Envyles/OpenAnalogToRS485/README.md

# OpenAnalogToRS485
A open analog to RS485 converter board based on the STM32 and ADC 1115.

I will write a Manual if i have some time in the next Days.

This STM32 based board is made for the purpose to read analog Data from enviromental sensors and provide it in a ascii style formated Output.

Its released under the Creative Commons CC BY-SA license. 

EN: https://creativecommons.org/licenses/by-sa/3.0/
DE: https://creativecommons.org/licenses/by-sa/3.0/de/

It is provided AS-IS, with no further Warranty.
