Envyles/OpenAnalogToRS485/BOM_Open-Analog-To-RS485_2021-02-01.csv

ID | Name | Designator | Footprint | Quantity | Manufacturer Part | Manufacturer | Supplier | Supplier Part | JLCPCB SMD | LCSC Assembly
1 | Header | RS485PIN | HDR-2X1/2.54 | 1 | Header-Male-2.54_1x2 | EasyEDA | EasyEDA | E36717
2 | Canbus 120 ohm terminator jumper | TERMINATORJUMPER_RS485 | HDR-2X1/2.54 | 1 | Header-Male-2.54_1x2 | EasyEDA | EasyEDA | E36717
3 | Power | POWER_CONECTOR,LED_CON | HDR-2X1/2.54 | 2 | Header-Male-2.54_1x2 | EasyEDA | EasyEDA | E36717
4 | ProgramHeader | PROGRAMMING | HDR-4X1/2.54 | 1 | Header-Male-2.54_1x4 | EasyEDA | EasyEDA | E59481
5 | BAV199 | D1,D2,D3,D4 | SOT-23-3_L3.0-W1.7-P0.95-LS2.9-BR | 4 | BAV199 | CJ | LCSC | C68971 | Yes
6 | 8MHz | X1 | OSC-SMD_L5.0-W3.2 | 1 | X50328MSB2GI | YXC | LCSC | C115962 | Yes
7 | 32.768KHz | X3 | SMD-2012_2P | 1 | DST210AC 32.768KHz | KDS | LCSC | C93231 | Yes
8 | 680uF | C14 | CAP-SMD_BD10.0-L10.3-W10.3-RD | 1 | VZH681M1CTR-1010 | LELON | LCSC | C164080 | Yes
9 | LM2596SX-5.0/NOPB | U9 | TO-263-5_L10.2-W9.9-P1.70-LS14.4-TL | 1 | LM2596SX-5.0/NOPB | TI | LCSC | C10002 | Yes
10 | 22uH | L3,L4,L5 | L0805 | 3 | SDFL2012T220KTF | Sunlord | LCSC | C32375 | Yes
11 | 1.5K | R15,R20,R22,R23,R24 | R0603 | 5 | 0603WAF1501T5E | UniOhm | LCSC | C22843 | Yes
12 | ADS1115IDGSR | U3 | MSOP-10_L3.0-W3.0-P0.50-LS5.0-BL | 1 | ADS1115IDGSR | TI | LCSC | C37593 | Yes
13 | SP3485EN-L/TR | U4 | SOIC-8_L5.0-W4.0-P1.27-LS6.0-BL | 1 | SP3485EN-L/TR | EXAR | LCSC | C8963 | Yes
14 | 12pF | C15,C18 | C0603 | 2 | CL10C120JB8NNNC | SAMSUNG | LCSC | C38523 | Yes
15 | AMS1117-3.3 | U1,U6 | SOT-223-3_L6.5-W3.4-P2.30-LS7.0-BR | 2 | AMS1117-3.3 | AMS | LCSC | C6186 | Yes
16 | 1.2K | R33,R25,R26,R27 | R0603 | 4 | 0603WAF1201T5E | UniOhm | LCSC | C22765 | Yes
17 | 10K | RN1,RN3,RN4 | RES-ARRAY-SMD_0402-8P-L2.0-W1.0-BL | 3 | 4D02WGJ0103TCE | UniOhm | LCSC | C25725 | Yes
18 | STM32F103C8T6 | U2 | LQFP-48_L7.0-W7.0-P0.50-LS9.0-BL | 1 | STM32F103C8T6 | STMicroelectronics | LCSC | C8734 | Yes
19 | 1uF | C4,C8 | C0603 | 2 | CL10A105KB8NNNC | SAMSUNG | LCSC | C15849 | Yes
20 | 19-217/BHC-ZL1M2RY/3T | P_DI,P_RO,P2,P1 | LED0603-R-RD | 4 | 19-217/BHC-ZL1M2RY/3T | EVERLIGHT | LCSC | C72041 | Yes
21 | 100uF | C1,C2,C10,C11,C22,C23 | CAP-SMD_L3.5-W2.8 | 6 | TAJB107K006RNJ | AVX | LCSC | C16133 | Yes
22 | 300 | R4,R6,R7,R2 | R0603 | 4 | 0603WAF3000T5E | UniOhm | LCSC | C23025 | Yes
23 | 120 | R19,R18,R3,R1,R5 | R0402 | 5 | 0402WGF1200TCE | UniOhm | LCSC | C25079 | Yes
24 | 30pF | C19,C16 | C0402 | 2 | 0402CG300J500NT | FH | LCSC | C1570 | Yes
25 | 100nF | C24,C13,C5,C6,C7,C25,C9,C3 | C0402 | 8 | CL05B104KO5NNNC | SAMSUNG | LCSC | C1525 | Yes
26 | PSM712-LF-T7 | D16,D17 | SOT-23-3_L3.0-W1.7-P0.95-LS2.9-BR | 2 | PSM712-LF-T7 | PROTEK | LCSC | C32677 | Yes
27 | B5819W_C8598 | D9,D10 | SOD-123_L2.8-W1.8-LS3.7-RD | 2 | B5819W | CJ | LCSC | C8598 | Yes
28 | 39nH | L1,L2 | L0402 | 2 | SDCL1005C39NJTDF | Sunlord | LCSC | C26443 |  | Yes
29 | HDR1x8 | ADCON1 | HDR1X8 | 1
30 | BOOTSELECTOR | BOOT0TO3 | HDR-2X1/2.54 | 1 | Header-Male-2.54_1x2 | EasyEDA | EasyEDA | E36717
