Envyles/OpenAnalogToRS485/(list of files, drawings)

Other design files:
Open-analog-to-RS485-PCB-EasyEDA_4Layer.json
Open-Analog-To-RS485_2021-02-01_EasyEDA_Export.json
