Envyles/OpenAnalogToRS485/(commit log)

2021-01-07 Initial Commit
    Initial Upload
    [BOM_Open-Analog-To-RS485_2021-01-07.csv, Open-Analog-To-RS485_2021-01-07_EasyEDA_Export.json, PickAndPlace_Open-Analog-To-RS485_2021-01-07.csv]
2021-01-07 [CC] Updated the board by removing the SA argument
2021-01-31 The Following two issues were handled:
    - A timing issue with the RS485 connection
    - Arduino Autoformat
    [Analog-To-RS485.ino]
2021-02-01 Added a filter for Powerinput of the ADS1115 to minimize noise
    [BOM_Open-Analog-To-RS485_2021-01-07.csv, BOM_Open-Analog-To-RS485_2021-02-01.csv, Open-Analog-To-RS485_2021-01-07_EasyEDA_Export.json, Open-Analog-To-RS485_2021-02-01_EasyEDA_Export.json, Open-analog-to-RS485-PCB-EasyEDA_4Layer.json, Open-analog-to-rs485-PCB-EasyEDA.json, PickAndPlace_Open-Analog-To-RS485_2021-01-07.csv, PickAndPlace_Open_Analog_To_RS485_4Layer_2021-02-01.csv]
2021-02-12 Added Linearity Calibration and License.md
